quantranle/WirelessEmergencyStopButton/pcb-design/readme.md

# PCB design

This image shows the PCB design of our project: Wireless Emergency Stop Button ESP8266 Schematic Figure 1: ESP8266 PCB design
