quantranle/WirelessEmergencyStopButton/resources/readme.md

# Resources

These are links or materials about the idea "Wireless Emergency Stop Button":

## ESP32
- [Get Started with ESP32](https://docs.espressif.com/projects/esp-idf/en/latest/esp32/get-started/index.html#introduction)
- [Choosing Low Power Mode in Wi-Fi Scenarios](https://docs.espressif.com/projects/esp-idf/en/latest/esp32/api-guides/low-power-mode/low-power-mode-wifi.html)
- [Tips for ESP8266](https://www.instructables.com/ESP8266-Pro-Tips/)

## LoRa
- [SX1268](https://www.mouser.de/ProductDetail/Semtech/SX1268IMLTRT?qs=u16ybLDytRa1EU1aQ4yjlw%3D%3D)

## Power Supply
- [Best battery for ESP32](https://diyi0t.com/best-battery-for-esp32-nodemcu/)

## Voltage regulator
- [SPX1117](https://www.mouser.de/ProductDetail/MaxLinear/SPX1117M3-L-3-3-TR?qs=S%2FCBhQS5rCofor8XCFP4ag%3D%3D)

## USB to UART
- [CP2102](https://www.mouser.de/ProductDetail/Silicon-Labs/CP2102N-A02-GQFN24?qs=u16ybLDytRYKabtL%2FE7DZA%3D%3D)

## Library for Schematic
- [Electronic Component Search Engine](https://componentsearchengine.com/)
