quantranle/WirelessEmergencyStopButton/idea/Project-Idea.md

# Project Title

**Wireless Emergency Stop Button using ESP32**
