quantranle/WirelessEmergencyStopButton/presentation/PE02_Final_ Presentation.pdf

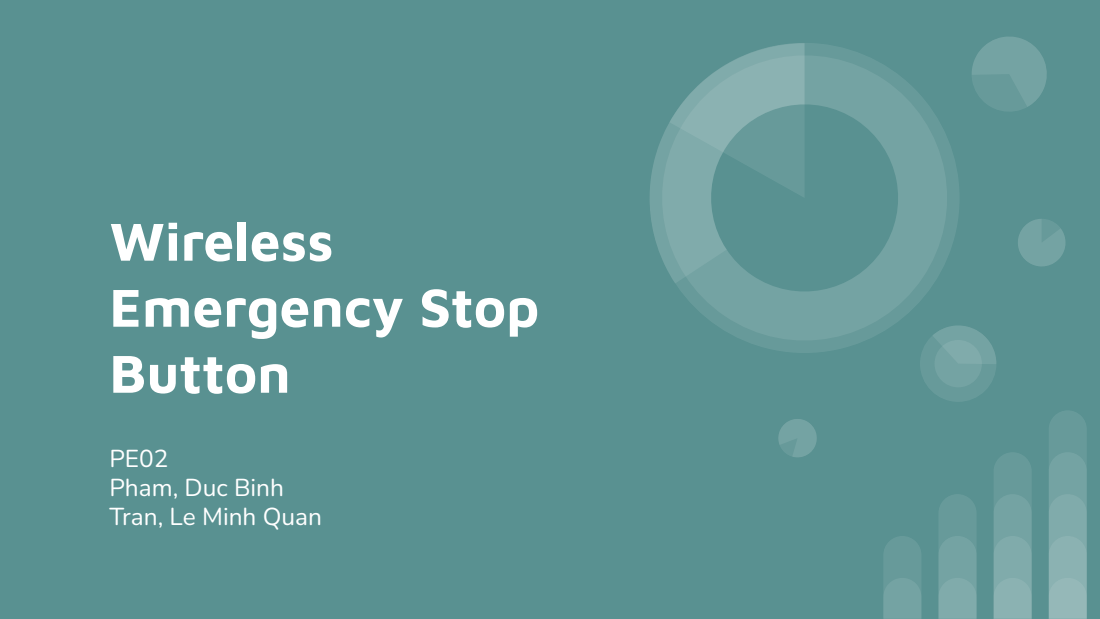
[picture p9: page 1]
Wireless Emergency Stop Button

Pham, Duc Binh
Tran, Le Minh Quan

## Inspiration

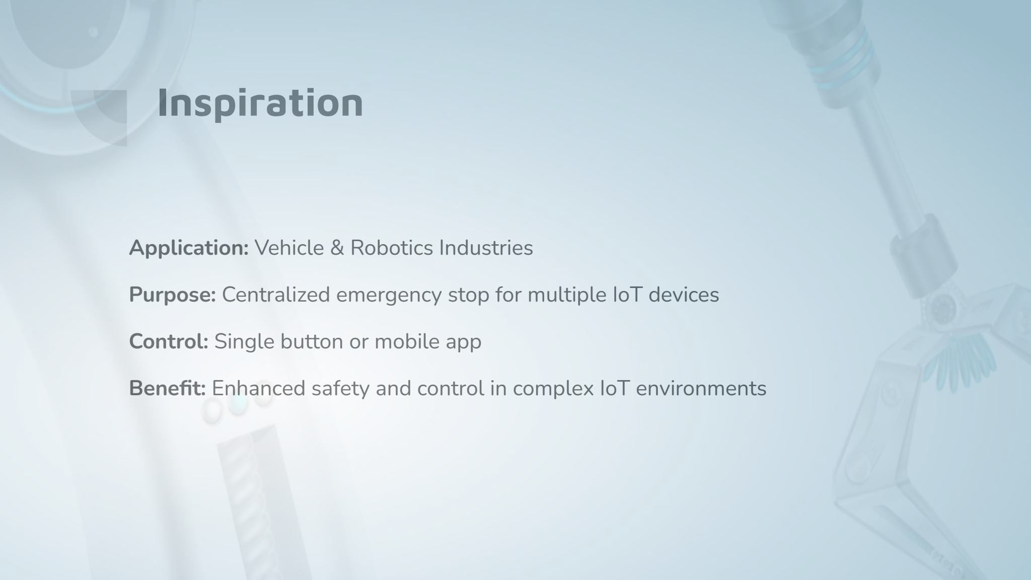
[picture p10: page 2]

Application: Vehicle & Robotics Industries
Purpose: Centralized emergency stop for multiple IoT devices Control: Single button or mobile app
Benefit: Enhanced safety and control in complex IoT environments

## PCB Design

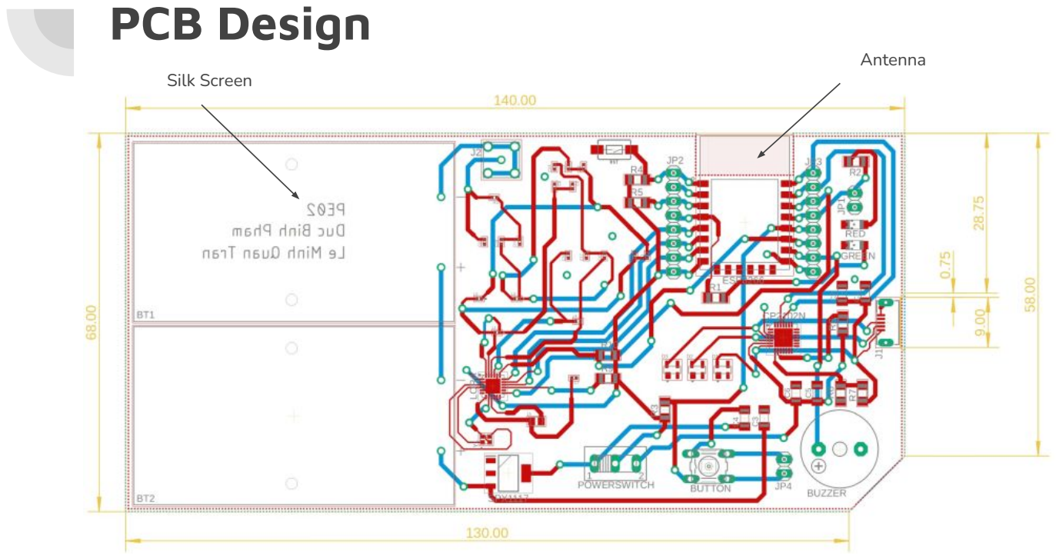
[picture p11: page 3]

Antenna
Silk Screen

## Manufacturing Product

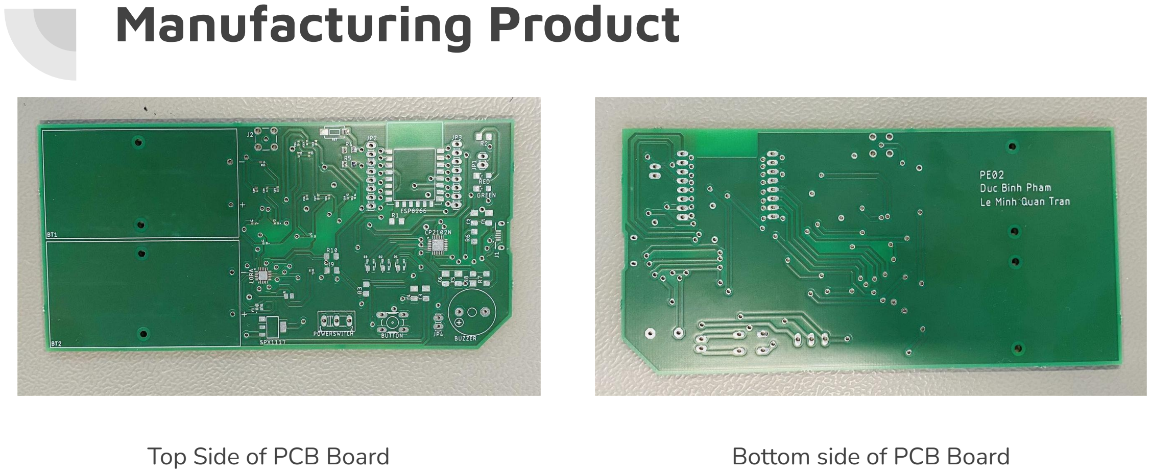
[picture p12: page 4]

Top Side of PCB Board | Bottom side of PCB Board

## Parts

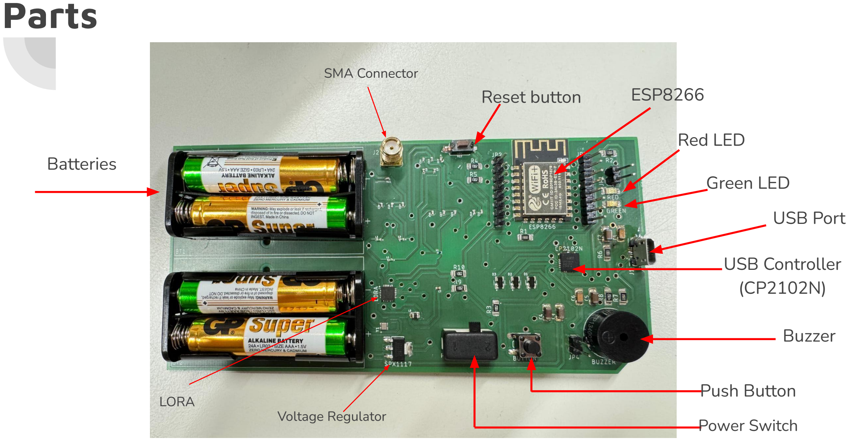
[picture p13: page 5]

Batteries

Power Switch

Push Button

Buzzer

USB Controller
(CP2102N)

USB Port

Green LED

Reset button | ESP8266
| Red LED

Voltage Regulator

SMA Connector

LORA

## Programing

### - FDTI FT232RL as bridge to flash the code into ESP - Programming in Arduino IDE - Install appropriate FTDI driver

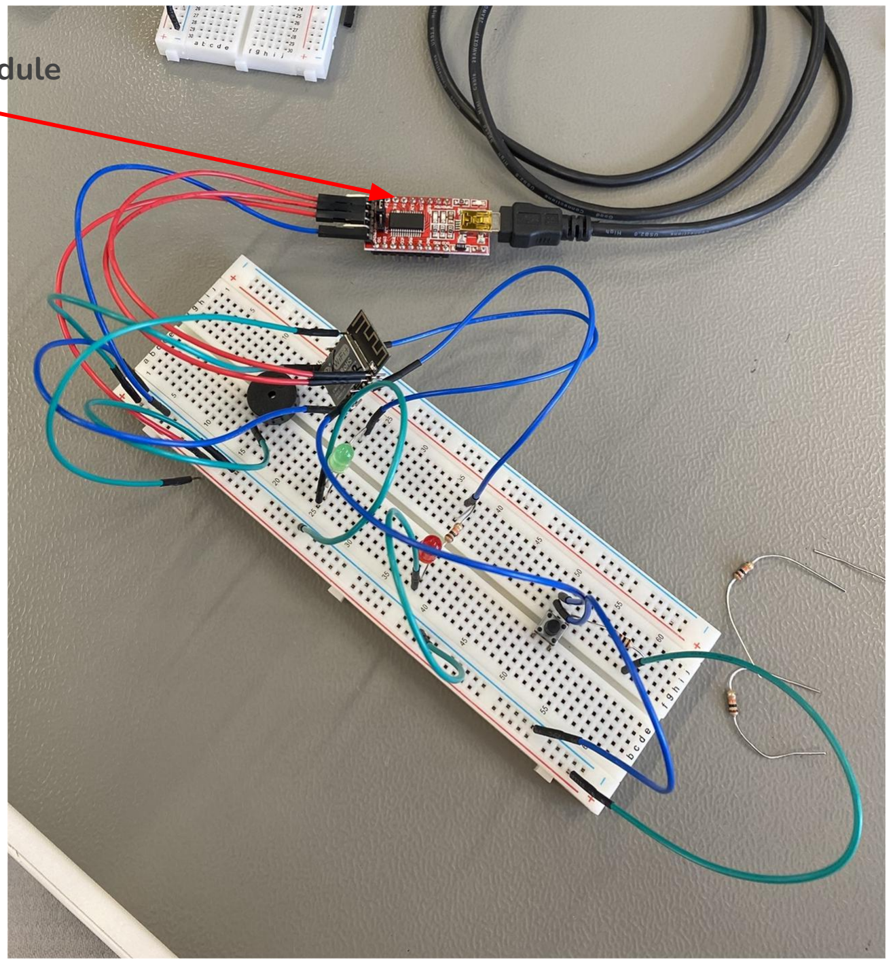
[picture p14: figure]

FDTI Module

## Result

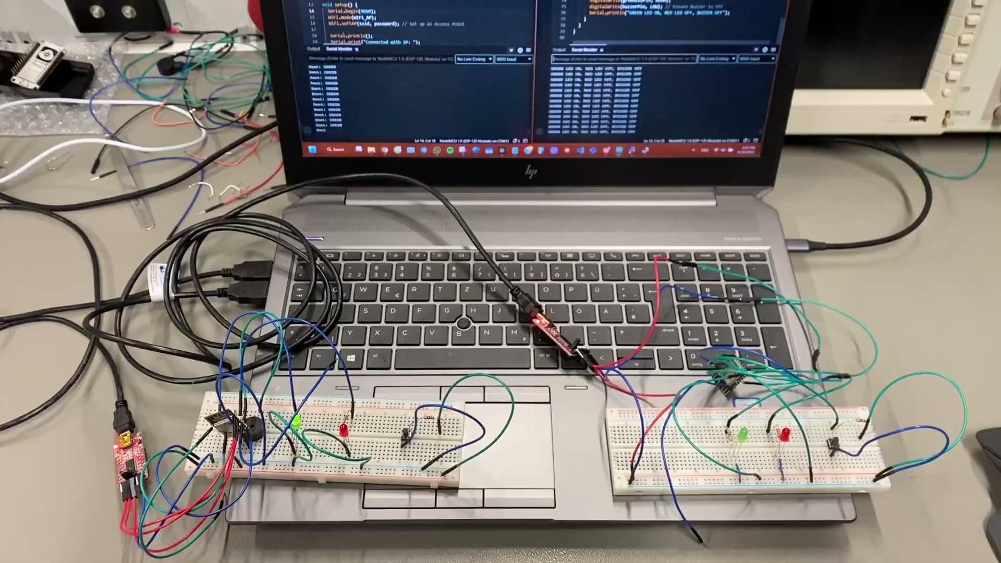
[picture p15: figure]
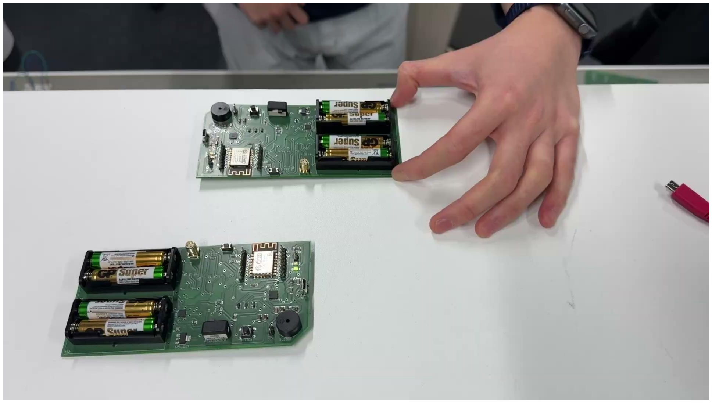
[picture p16: figure]

Video 1: Prototyping with FDTI FT232RL Module | Video 2: Prototyping in PCB

## Power Consumption (of batteries)

V_supply = 5.5V (measured)

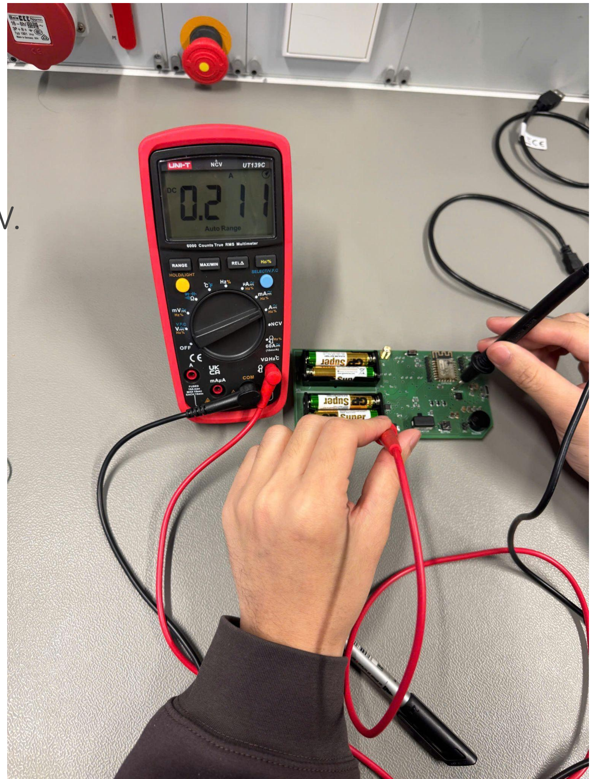
[picture p17: figure]

I_output = 200mA (measured) ⇒ P_consumed = V_supply * I_ouput = 5.5V * 200mA = 1100 mW. ● P_consumed = 1100 mW

## Battery Life

Battery capacity of AAA Alkaline: 1200 mAh (datasheet)

Battery Life = 1200mAh / 200mA = 6 hours

## Problem 1: Usb Controller

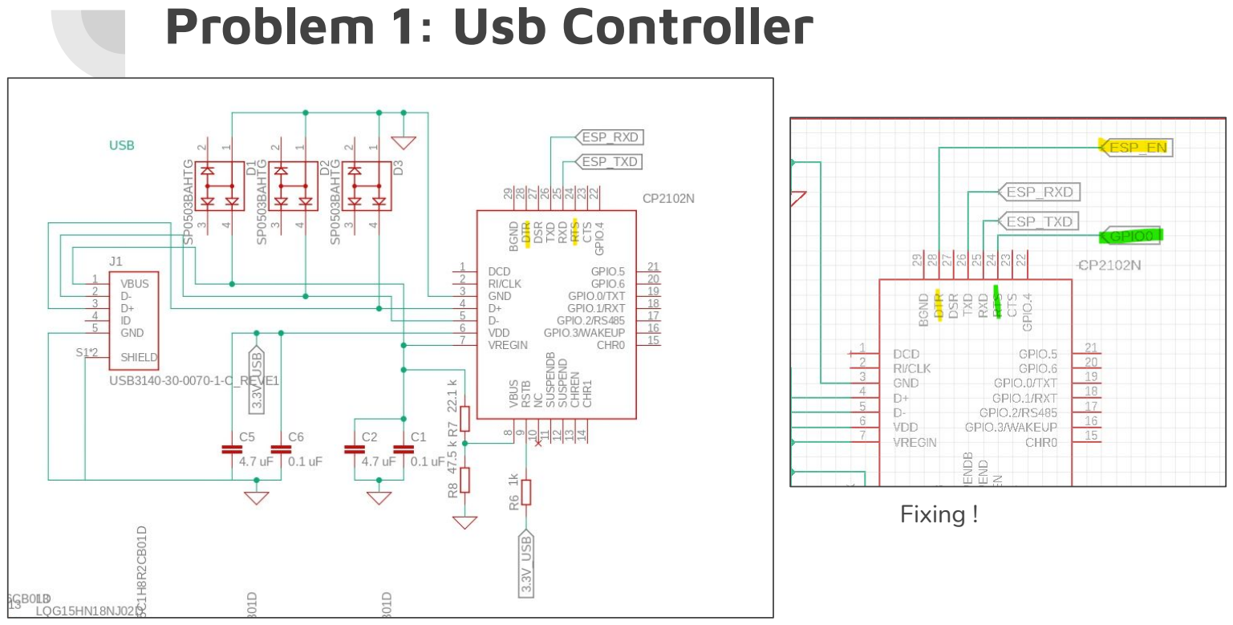
[picture p18: page 9]

Error at connection DTR and RTS port ! | Fixing !

## Further Improvements

### 1. Integration with Other Devices: Integrate wireless e-stops with

other E-Carts or Robots to create a comprehensive safety network.

### 2. Further Program Development: Sleep mode to optimize the

battery life

### 3. Application of The Lora Module to increase distance and reliable

communication.

### 4. Ergonomic Design: Ensure ergonomic design for comfortable and

intuitive operation (Push button, battery level, signal strength,…)

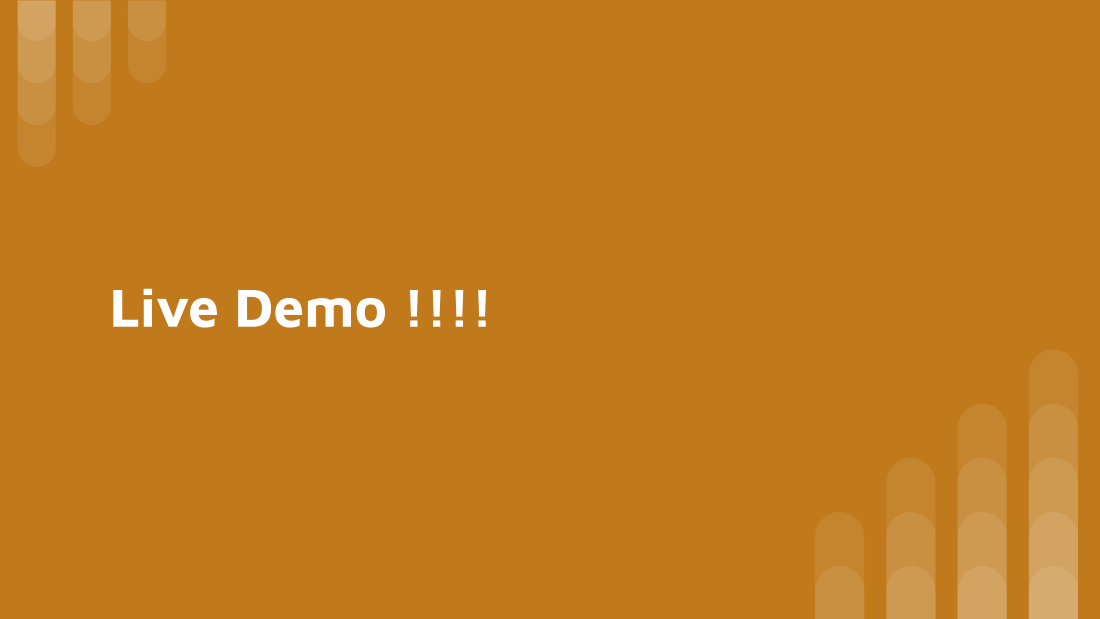
[picture p19: page 11]
Live Demo !!!!

# Thank You

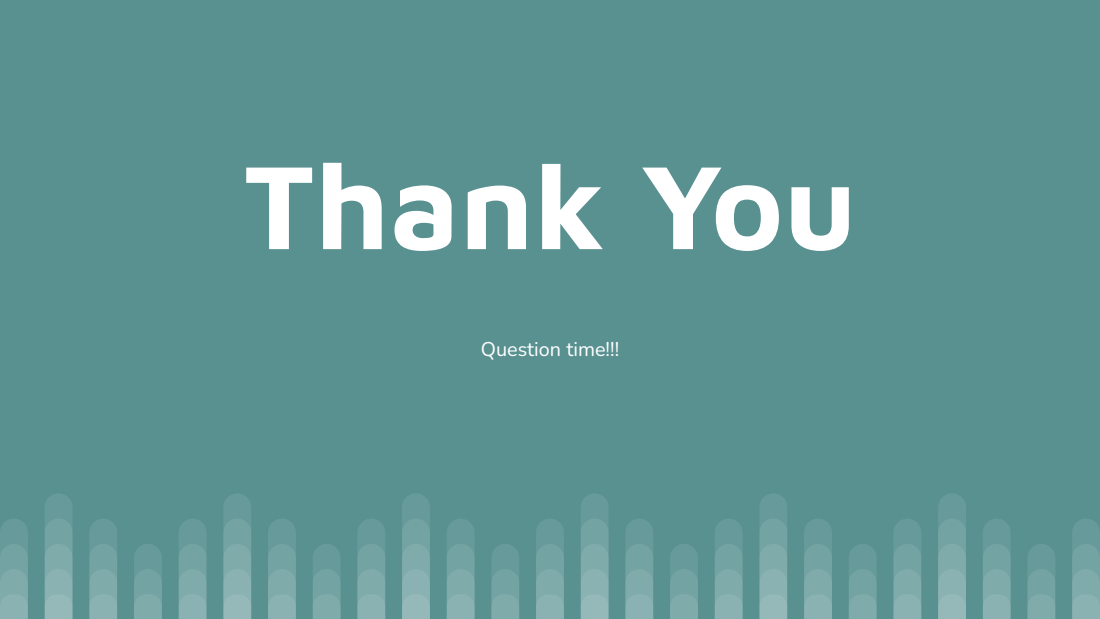
[picture p20: page 12]
Question time!!!
