quantranle/WirelessEmergencyStopButton/pcb-design/pe02.pdf

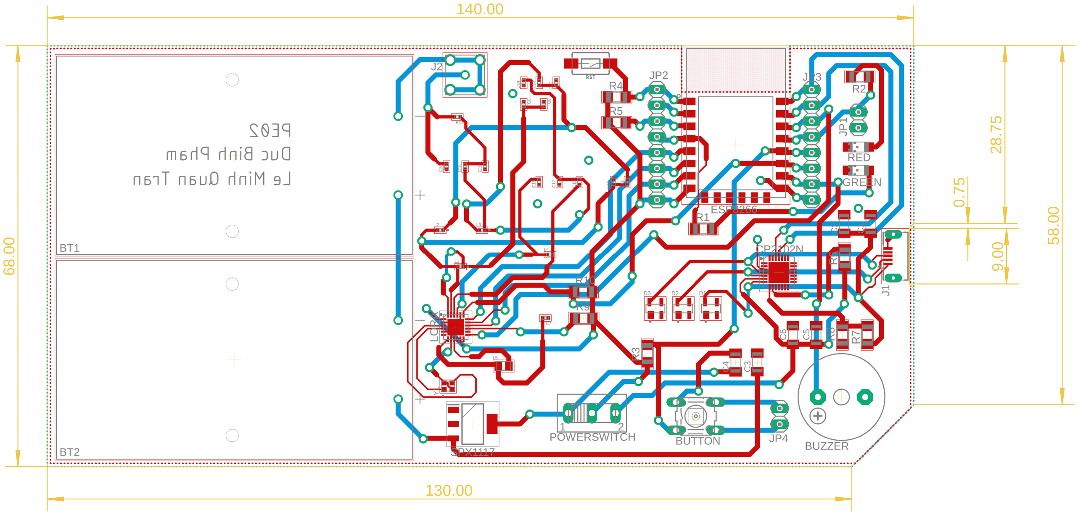
[picture p21: figure]
