quantranle/WirelessEmergencyStopButton/resources/FDTI module.jpg

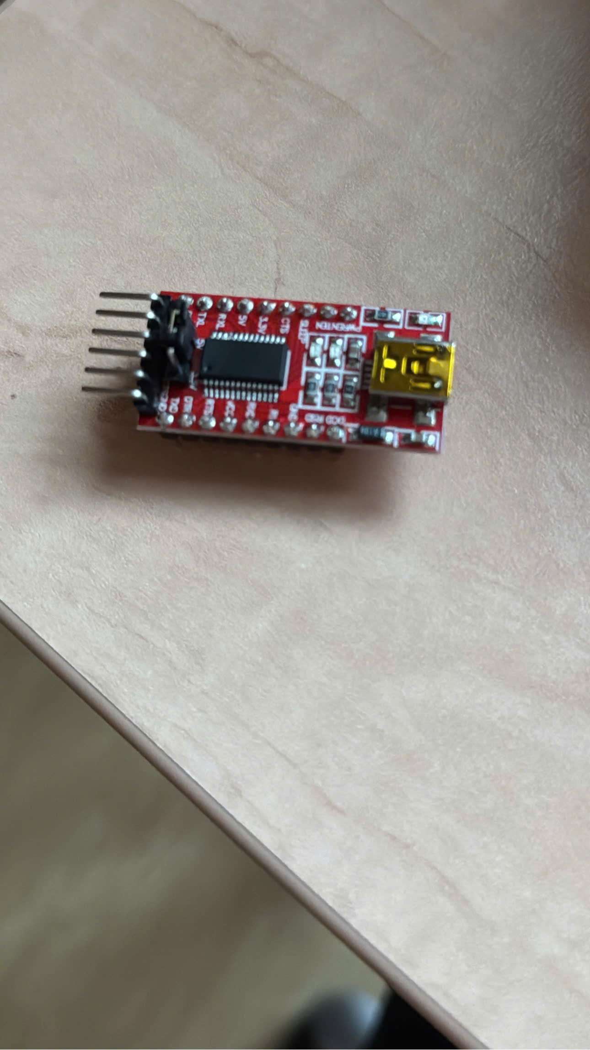
resources/FDTI module.jpg
