quantranle/WirelessEmergencyStopButton/resources/prototyping.png

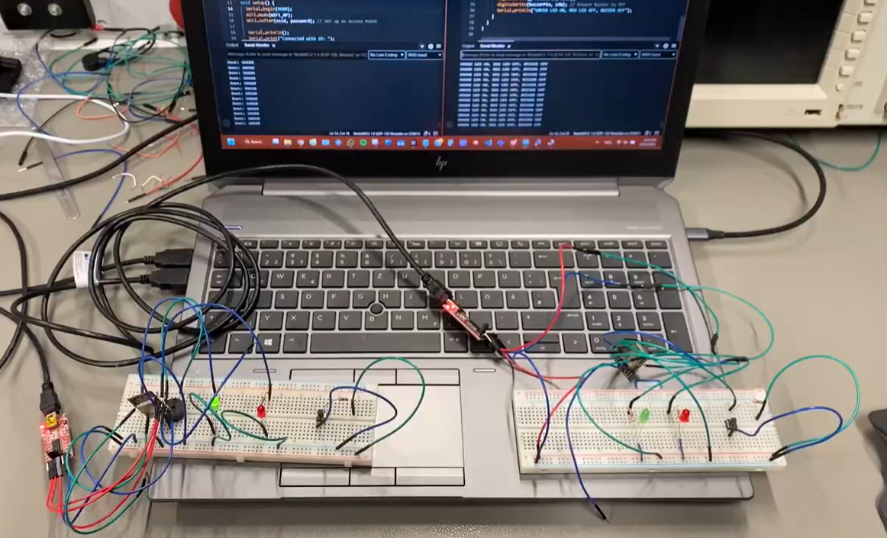
resources/prototyping.png
