quantranle/WirelessEmergencyStopButton/schematic-design/pe02.pdf

# ESP_RXD ESP_RXD

# ESP_TXD ESP_TXD

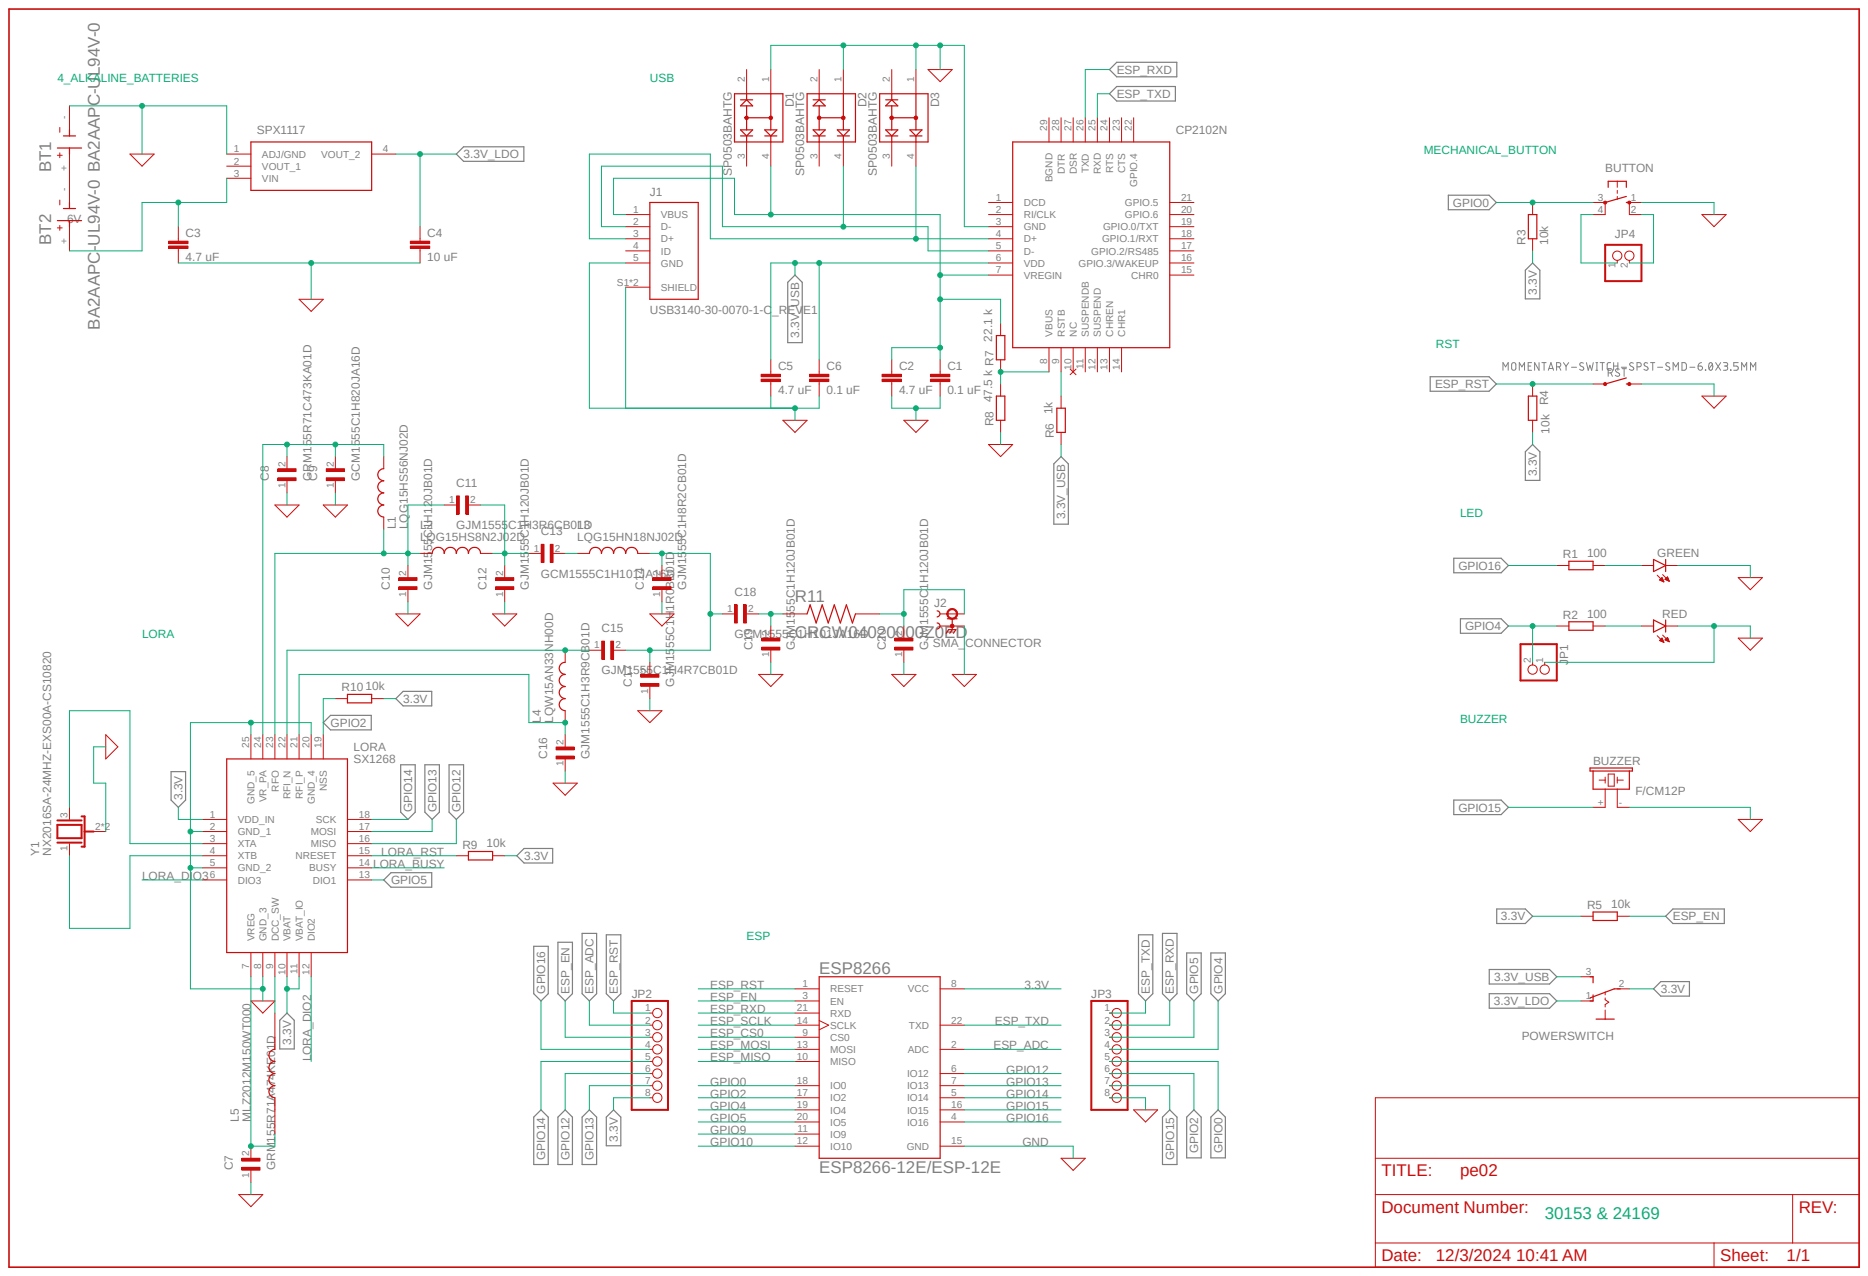
[picture p24: page 1]

Document Number: 30153 & 24169 | REV:

Date: 12/3/2024 10:41 AM | Sheet: 1/1
