quantranle/WirelessEmergencyStopButton/pcb-design/pe02.brd

## EAGLE design pcb-design/pe02.brd (2025-02-15)

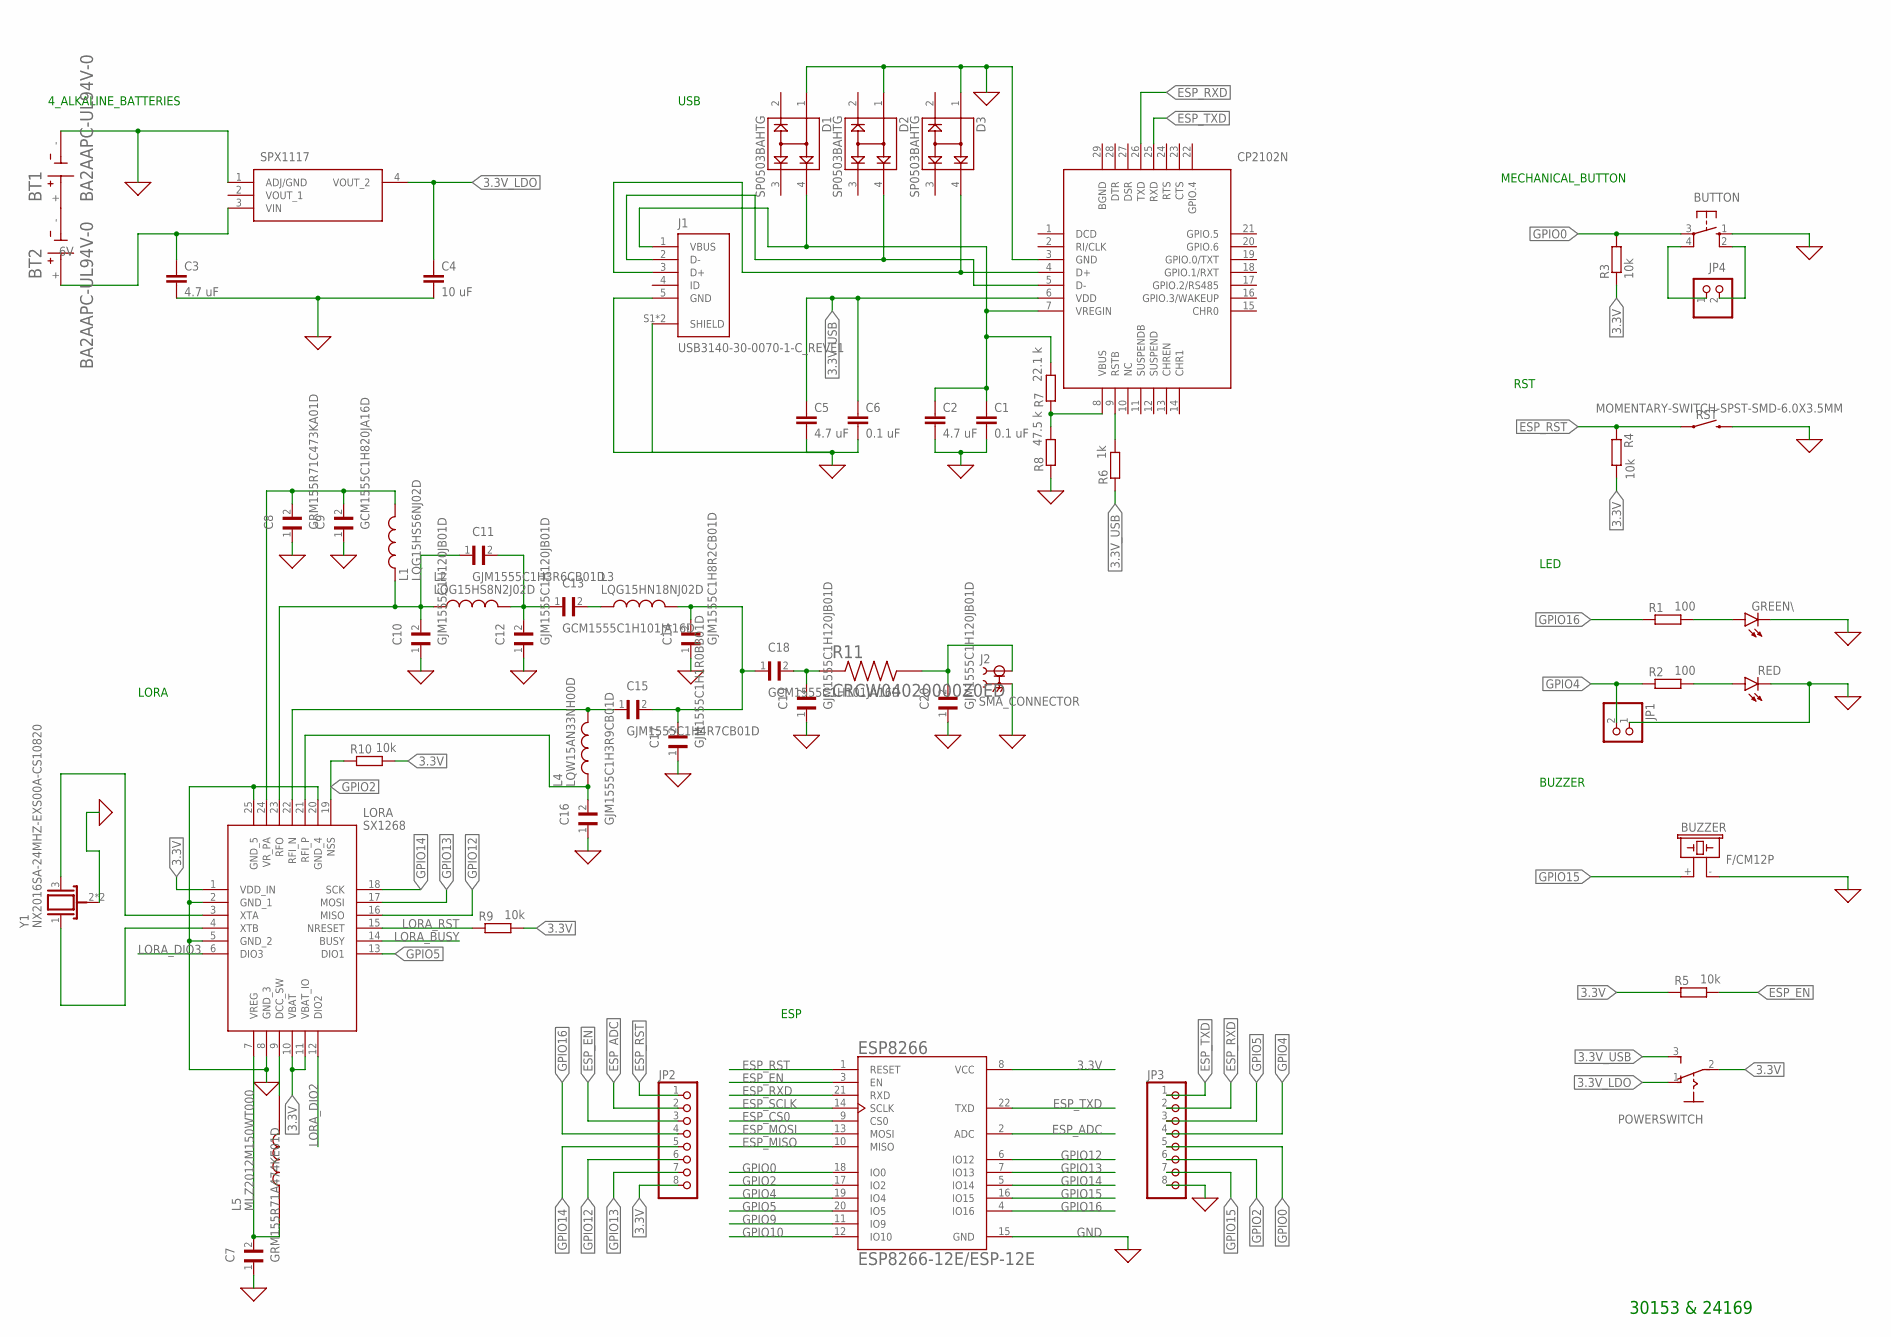
[picture p25: schematic pe02.sch]

Parts:
BT1, BT2: BA2AAPC-UL94V-0; BAT_BA2AAPC-UL94V-0
BUTTON: 10-XX; B3F-10XX
BUZZER: F/CM12P
C1, C6: 0.1 uF; C1206K
C2, C3, C5: 4.7 uF; C1206K
C4: 10 uF; C1206K
C7: GRM155R71A474KE01D; CAPC1005X55N
C8: GRM155R71C473KA01D; CAPC1005X55N
C9: GCM1555C1H820JA16D; CAPC1005X55N
C10, C12, C19, C20: GJM1555C1H120JB01D; CAPC1005X55N
C11: GJM1555C1H3R6CB01D; CAPC1005X55N
C13, C18: GCM1555C1H101JA16D; CAPC1005X55N
C14: GJM1555C1H8R2CB01D; CAPC1005X55N
C15: GJM1555C1H4R7CB01D; CAPC1005X55N
C16: GJM1555C1H3R9CB01D; CAPC1005X55N
C17: GJM1555C1H1R0BB01D; CAPC1005X55N
CP2102N: CP2102N-A02-GQFN28; QFN50P500X500X80-29N
D1, D2, D3: SP0503BAHTG; SOT143
ESP8266: ESP8266-12E/ESP-12E; XCVR_ESP8266-12E/ESP-12E
GREEN\: LEDCHIPLED_1206; CHIPLED_1206
J1: USB3140-30-0070-1-C_REVE1; GCT_USB3140-30-0070-1-C_REVE1
J2: SMA_CONNECTOR; LPRS_SMA_CONNECTOR
JP1, JP4: PINHD-1X2; 1X02
JP2, JP3: PINHD-1X8; 1X08
L1: LQG15HS56NJ02D; INDC1005X55N
L2: LQG15HS8N2J02D; INDC1005X55N
L3: LQG15HN18NJ02D; INDC1005X55N
L4: LQW15AN33NH00D; INDC1005X60N
L5: MLZ2012M150WT000; INDC2012X145N
LORA: SX1268; QFN50P400X400X100-25N
POWERSWITCH: 255SB
R1, R2: 100; R1206
R3, R4, R5, R9, R10: 10k; R1206
R6: 1k; R1206
R7: 22.1 k; R1206
R8: 47.5 k; R1206
R11: CRCW04020000Z0ED; RESC1005X40N
RED: LEDCHIPLED_1206; CHIPLED_1206
RST: MOMENTARY-SWITCH-SPST-SMD-6.0X3.5MM; TACTILE_SWITCH_SMD_6.0X3.5MM
SPX1117: SPX1117M3-L-3-3_TR; SOT230P700X180-4N
Y1: NX2016SA-24MHZ-EXS00A-CS10820; OSC_NX2016SA-24MHZ-EXS00A-CS10820

Connections:
3.3V: ESP8266.8 (VCC), JP2.8, LORA.1 (VDD_IN), LORA.10 (VBAT), LORA.11 (VBAT_IO), POWERSWITCH.2, R3.1, R4.2, R5.1, R9.2, R10.2
3.3V_LDO: C4.1, POWERSWITCH.1 (O), SPX1117.4 (VOUT_2)
3.3V_USB: C5.1, C6.1, CP2102N.6 (VDD), POWERSWITCH.3 (S), R6.1
6V: BT2.+, C3.1, SPX1117.3 (VIN)
BGND: CP2102N.29 (BGND)
ESP_ADC: ESP8266.2 (ADC), JP2.2
ESP_CS0: ESP8266.9 (CS0)
ESP_EN: ESP8266.3 (EN), JP2.3, R5.2
ESP_MISO: ESP8266.10 (MISO)
ESP_MOSI: ESP8266.13 (MOSI)
ESP_RST: ESP8266.1 (RESET), JP2.1, R4.1, RST.1
ESP_RXD: CP2102N.26 (TXD), ESP8266.21 (RXD), JP3.2
ESP_SCLK: ESP8266.14 (SCLK)
ESP_TXD: CP2102N.25 (RXD), ESP8266.22 (TXD), JP3.1
GND: BT1.-, BUTTON.1 (S), BUZZER.- (2), C1.2, C2.2, C3.2, C4.2, C5.2, C6.2, C7.1, C8.1, C9.1, C10.1, C12.1, C14.1, C16.1, C17.1, C19.1, C20.1, CP2102N.3 (GND), D1.1, D2.1, D3.1, ESP8266.15 (GND), GREEN\.C, J1.5 (GND), J1.S1 (SHIELD), J1.S2 (SHIELD), J2.G1 (2), J2.G2 (2), J2.G3 (2), J2.G4 (2), JP1.1, JP3.8, LORA.2 (GND_1), LORA.5 (GND_2), LORA.8 (GND_3), LORA.20 (GND_4), LORA.25 (GND_5), R8.1, RED.C, RST.2, SPX1117.1 (ADJ/GND), Y1.2 (GND), Y1.4 (GND)
GPIO0: BUTTON.3, ESP8266.18 (IO0), JP3.5, R3.2
GPIO2: ESP8266.17 (IO2), JP3.6, LORA.19 (NSS), R10.1
GPIO4: ESP8266.19 (IO4), JP1.2, JP3.4, R2.1
GPIO5: ESP8266.20 (IO5), JP3.3, LORA.13 (DIO1)
GPIO9: ESP8266.11 (IO9)
GPIO10: ESP8266.12 (IO10)
GPIO12: ESP8266.6 (IO12), JP2.6, LORA.16 (MISO)
GPIO13: ESP8266.7 (IO13), JP2.7, LORA.17 (MOSI)
GPIO14: ESP8266.5 (IO14), JP2.5, LORA.18 (SCK)
GPIO15: BUZZER.+ (1), ESP8266.16 (IO15), JP3.7
GPIO16: ESP8266.4 (IO16), JP2.4, R1.1
LORA_BUSY: LORA.14 (BUSY)
LORA_DIO2: LORA.12 (DIO2)
LORA_DIO3: LORA.6 (DIO3)
LORA_RFI_N: C15.1, L4.2, LORA.22 (RFI_N)
LORA_RFI_P: C16.2, L4.1, LORA.21 (RFI_P)
LORA_RFO: C10.2, C11.1, L1.1, L2.1, LORA.23 (RFO)
LORA_RST: LORA.15 (NRESET), R9.1
LORA_VR_PA: C8.2, C9.2, L1.2, LORA.24 (VR_PA)
LORA_XTA: LORA.3 (XTA), Y1.3
LORA_XTB: LORA.4 (XTB), Y1.1
unnamed: BUTTON.4 (P1), JP4.1
unnamed: BUTTON.2 (S1), JP4.2
unnamed: C7.2, L5.1, LORA.7 (VREG)
unnamed: L5.2, LORA.9 (DCC_SW)
unnamed: CP2102N.5 (D-), D2.4, J1.2 (D-)
unnamed: C13.2, L3.1
unnamed: GREEN\.A, R1.2
unnamed: R2.2, RED.A
unnamed: C11.2, C12.2, C13.1, L2.2
unnamed: BT1.+, BT2.-
unnamed: C14.2, C15.2, C17.2, C18.1, L3.2
unnamed: C20.2, J2.1, R11.2
unnamed: C18.2, C19.2, R11.1
unnamed: CP2102N.4 (D+), D3.4, J1.3 (D+)
unnamed: CP2102N.9 (RSTB), R6.2
unnamed: CP2102N.8 (VBUS), R7.1, R8.2
unnamed: C1.1, C2.1, CP2102N.7 (VREGIN), D1.4, J1.1 (VBUS), R7.2

Notes on the sheet:
MECHANICAL_BUTTON
4_ALKALINE_BATTERIES
LORA
USB
30153 & 24169
RST
LED
BUZZER
ESP

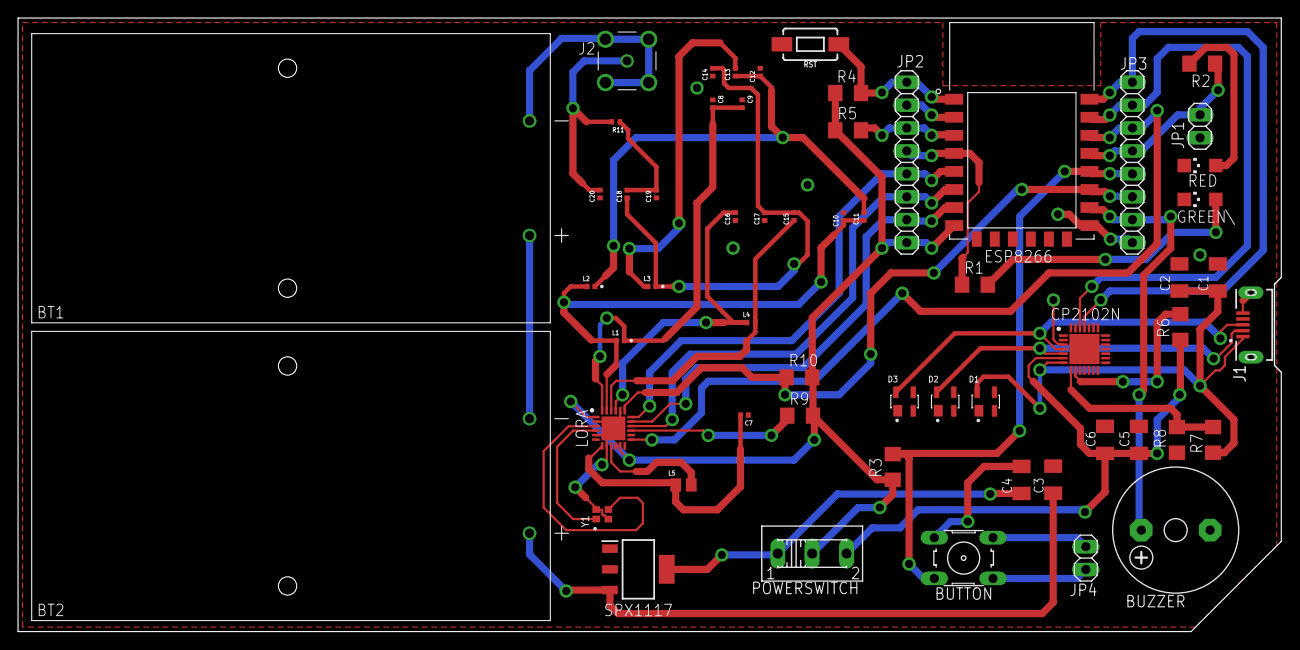
[picture p26: board pe02.brd from above]

Board: 2 copper layers, 140.0 x 68.0 mm, 58 parts (0 on the bottom side), 43 nets.
